onom25/work/301s/readme.txt

301s_drive1		ピエゾドライバー、ディスクリート版
301s_drive2		ピエゾドライバー、廉価版
301s_FT202H		FT232Hアクセスモック
FT232H_powershell	FT232H高速転送評価ツール
FT232H_quartus		301s_FT232H用のQuartus
wave_301s		cygwin 波形情報の読込、書込ツール
mmp5500_301s		DMX100の専用ファーム server\Elec\mmp301s\prototype\mmp5500_301s で管理する
