onom25/work/301s/wave_301s/readme.txt

wave_301s は、DMX100の波形を外部から指定するためのツールである。

引数
wave_301s.exe 192.168.1.170 argv[2] argv[3] argv[4]
引数を英小文字で指定した場合は大文字に内部で変換される。

RRANK
	ヘッドランクIDと波形番号をターゲットから読み込み、tmp.dat構造体に格納する。

RKIND
	FPGAの波形毎先頭アドレスレジスタ 0x0500_0044 から 0x0500_0050 までの
	値をターゲットから読み込み、tmp.dat構造体に格納する
	ヘッドと放熱器のサーミスタ温度も読み込まれる。

RWAVE <adr> <len>
	FPGAの波形メモリの任意番地を指定長さで読み込む。
	<adr> <len> が無指定の場合は 先頭 0x0500_8000 から 0x0500_BFFF までの
	16KB を読み込む。
	読み込んだ値は、 tmp.dat構造体ファイルに格納される。

DISP <名称>
	tmp.dat に格納されている波形情報を表示する。(ターゲットの値ではない)
	名称							(別称)
	RANK		ヘッドランク
	KIND		波形毎先頭アドレスレジスタ値
	STOP		停止波形データ		(_stop)
	START		開始波形データ		(_start)
	TERMINATE	終端波形データ		(_terminate)
	ROCK4		印字外微振動波形	(_rocking_outofarea)
	ROCK5		印字前微振動波形	(_rocking_beforeprint)
	FLASH		フラッシング波形	(_flashing)
	PRINT		印字波形			(_print)

	+------------------------------------------------------
	| no. E N C L  DAC         [ROCK5] wave head point 0x0680
	|   0 1 0 0 0 0x010e[  270]
	|
	E列 ENB		0のデータで波形の終わりとしている
	N列 NCHG	NCHG信号
	C列 CH		CH信号
	L列 LAT		LAT信号
		[ROCK5]波形は オフセット0x0680 の先頭から、始まっている。

WRANK <波形番号>
	0	F1440-VSD2(微振動なし)
	1	F1440-VSD2(微振動あり)
	2	PX5800-VSD2
	3	default(試験波形)

	20	評価機能
		プリンター内部の波形メモリーと波形毎先頭アドレスレジスタ更新を

	ヘッドランク自体を更新する機能はない。

WKIND <名称 | UPDATE> <値>
	名称( STOP | START | TERMINATE | ROCK4 | ROCK5 | FLASH | PRINT )の
	各波形先頭番地をしていするFPGAレジスタ値を入力する
	この変更においては tmp.dat構造体だけが更新され、ターゲットには反映されない
	値は 16進で (0x0..0x3ffc)の範囲で偶数指定する。
	終端データを含むと0x3ffe番地を指定することはできない、為受け付けない。

	名称(UPDATE) 値(0)
	名称にUPDATEを指定すると、tmp.dat構造体に保管されている値をターゲット
	に設定する

//--以下未実装

FSET <filename>
	構造体ファイルを開き、各波形先頭番地 と 波形メモリの全てを
	ターゲットに書き込む
	波形番号は反映されない。
	構造体ファイルを保管し、波形番号を20にすることで用意に波形を任意に
	指定できる。
