onom25/work/301s/FT232H_quartus/readme.txt

20260421
	_RXF立ち下がり直後に_RDに異常アサートが発生した点を対策した。
	修正したが治っていない。最初のnRDが1CLKに足りず、2サイクル目から有効なnRDとなっている。
20260423
	nRDの役割がデータ要求ではなく、受信ACK あるいは 次受信データ要求なので、ステートマシン変更

送信試験をしたいけれど UISWの動作が検証できない。
