onom25/work/301s/301s_drive1/memo20270804.pdf

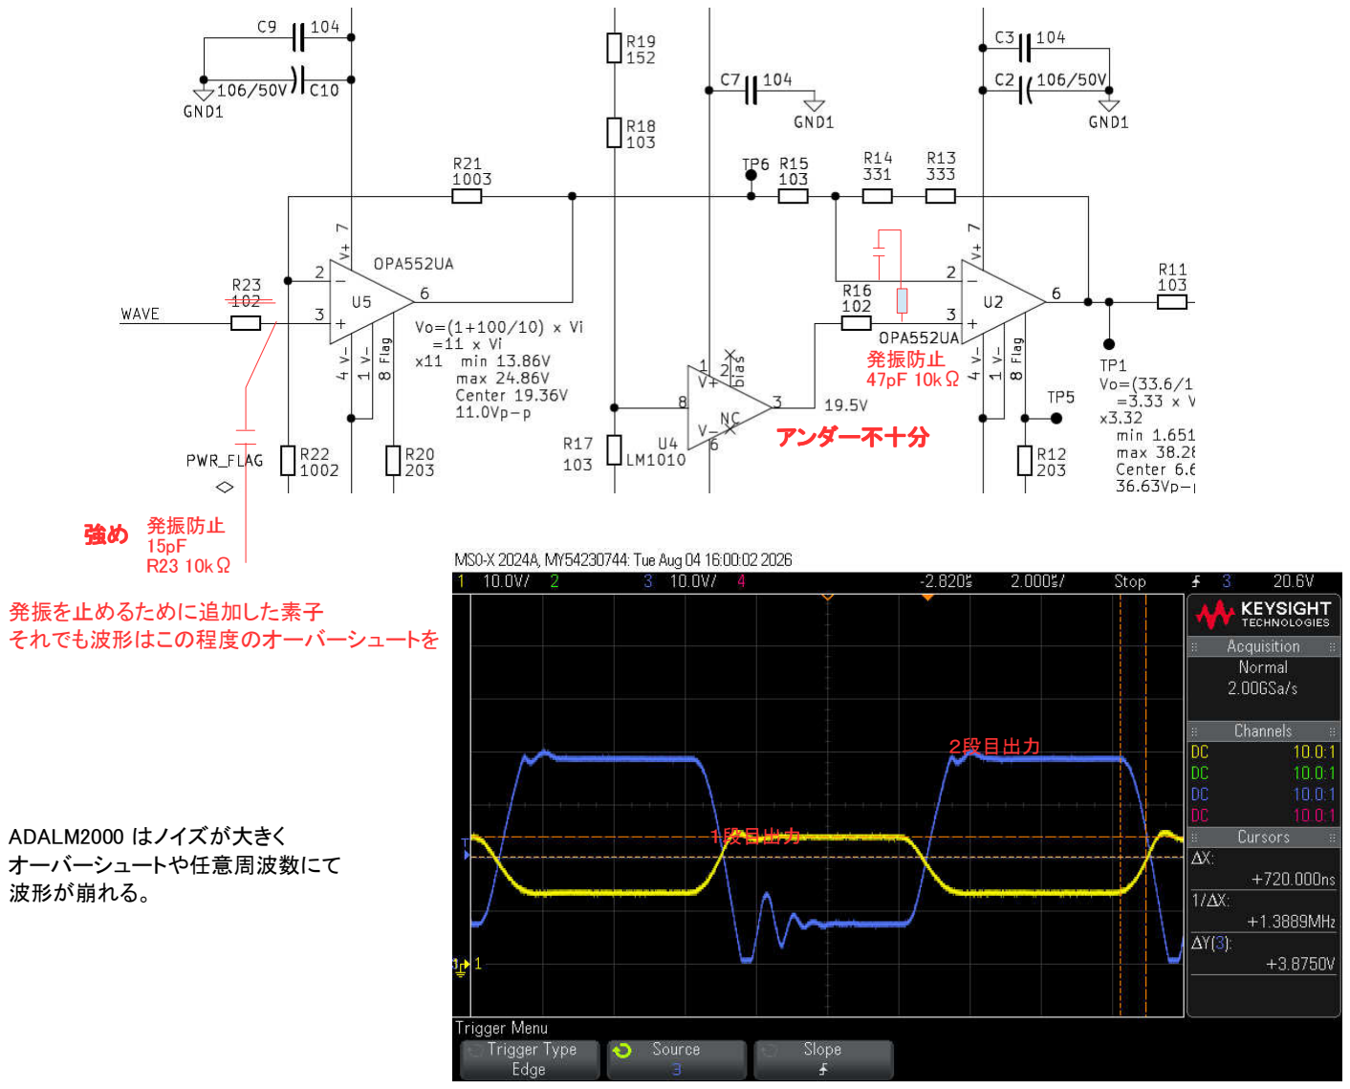
[picture p1: page 1]

発振を止めるために追加した素子
それでも波形はこの程度のオーバーシュートを

オーバーシュートや任意周波数にて
波形が崩れる。

ADALM2000 はノイズが大きく

強め

発振防止
47pF 10kΩ

発振防止
15pF
R23 10kΩ

１段目出力

２段目出力

アンダー不十分
