onom25/work/301s/FT232H_powershell/実行.png

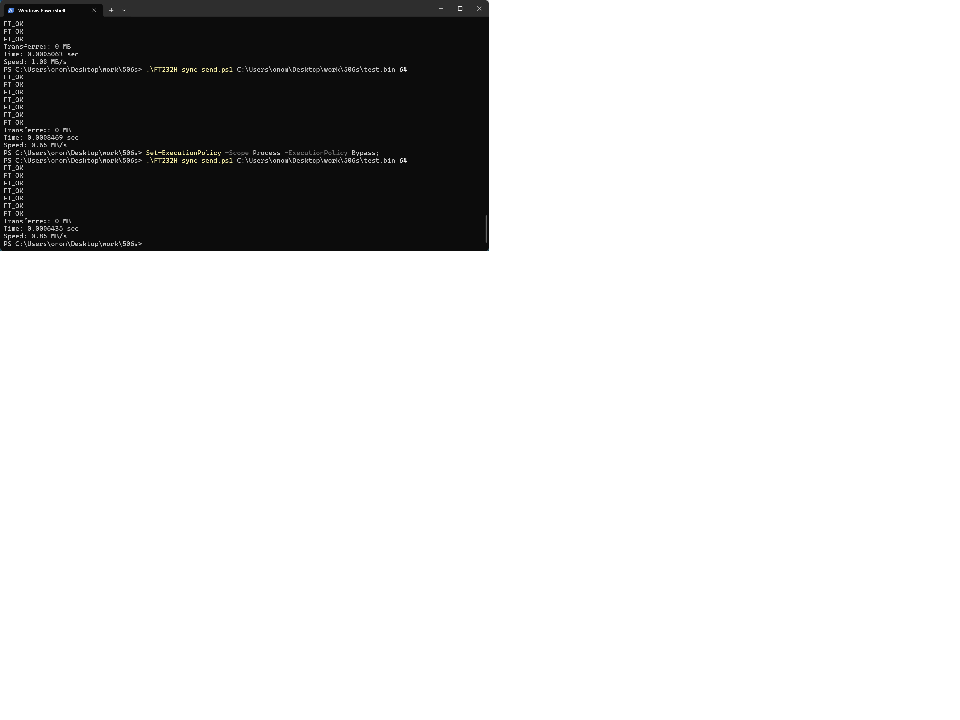
301s/FT232H_powershell/実行.png
