onom25/work/Mechanical/etcUnit/ASSY_CAP.stp

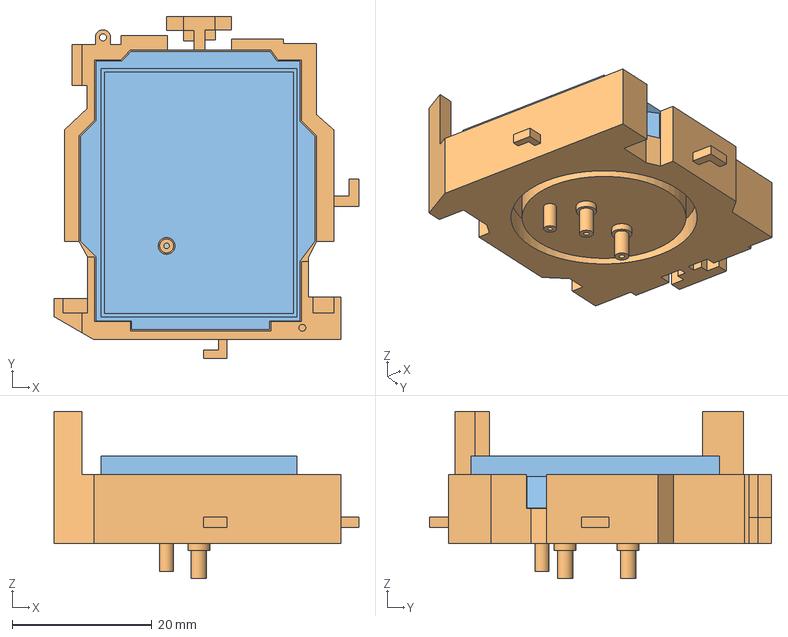
[picture p3: CAD file, 2026-06-05]
Mechanical/etcUnit/ASSY_CAP.stp
43.6 x 48.9 x 23.9 mm
Cap_holder
Blade
