onom25/work/Mechanical/etcUnit/P12-2GT-60.stp

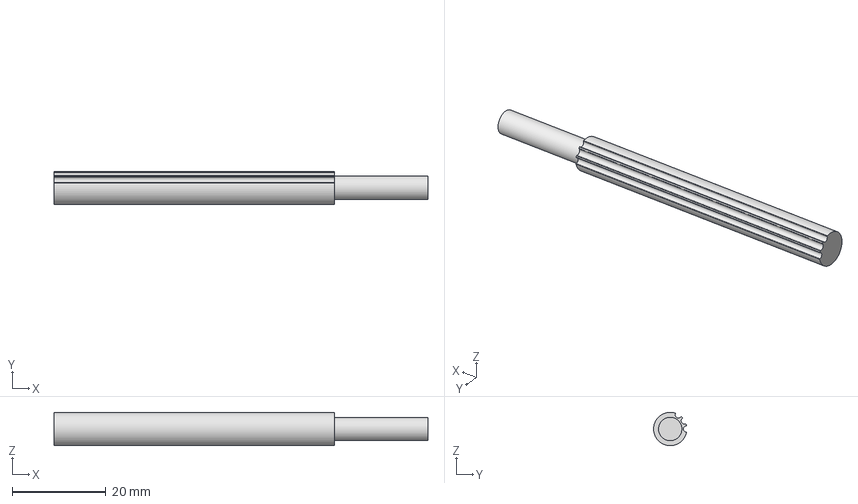
[picture p4: CAD file, 2026-10-16]
Mechanical/etcUnit/P12-2GT-60.stp
80.0 x 7.04 x 7.13 mm
