onom25/work/Mechanical/RGEAPL0.8KA-60-A5.stp

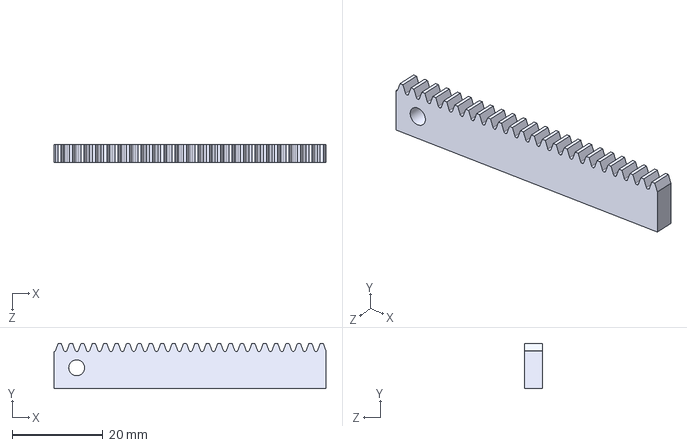
[picture p5: CAD file, 2026-10-16]
Mechanical/RGEAPL0.8KA-60-A5.stp
60.0 x 10.0 x 4.00 mm
