onom25/work/Mechanical/etcUnit/P13-1.5GT-1.5-33.stp

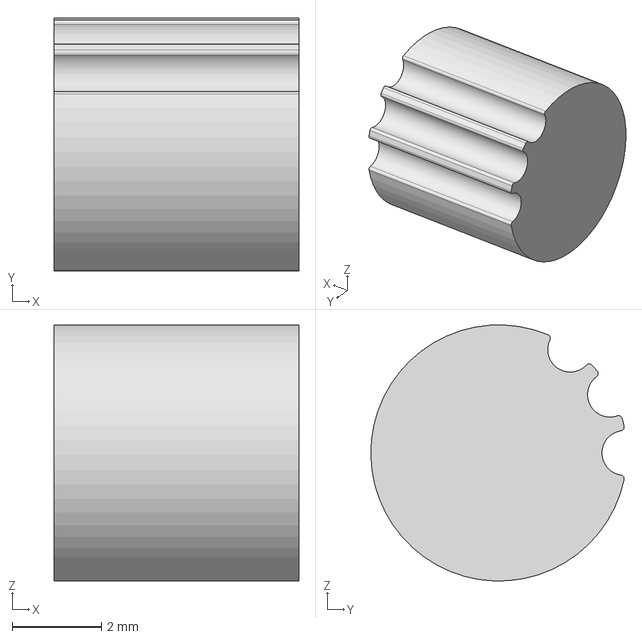
[picture p6: CAD file, 2026-10-16]
Mechanical/etcUnit/P13-1.5GT-1.5-33.stp
5.50 x 5.69 x 5.75 mm
