onom25/work/(list of files, cad)

Other CAD files:
301s/FT232H_quartus/db/uisw_auto_stripped.stp
301s/FT232H_quartus/nRD001.stp
301s/FT232H_quartus/db/nRD001_auto_stripped.stp
301s/FT232H_quartus/uisw.stp
