onom25/work/301s/FT232H_quartus/testbench/tb_testFT232H.pdf

読込1 | 書込1

読込2

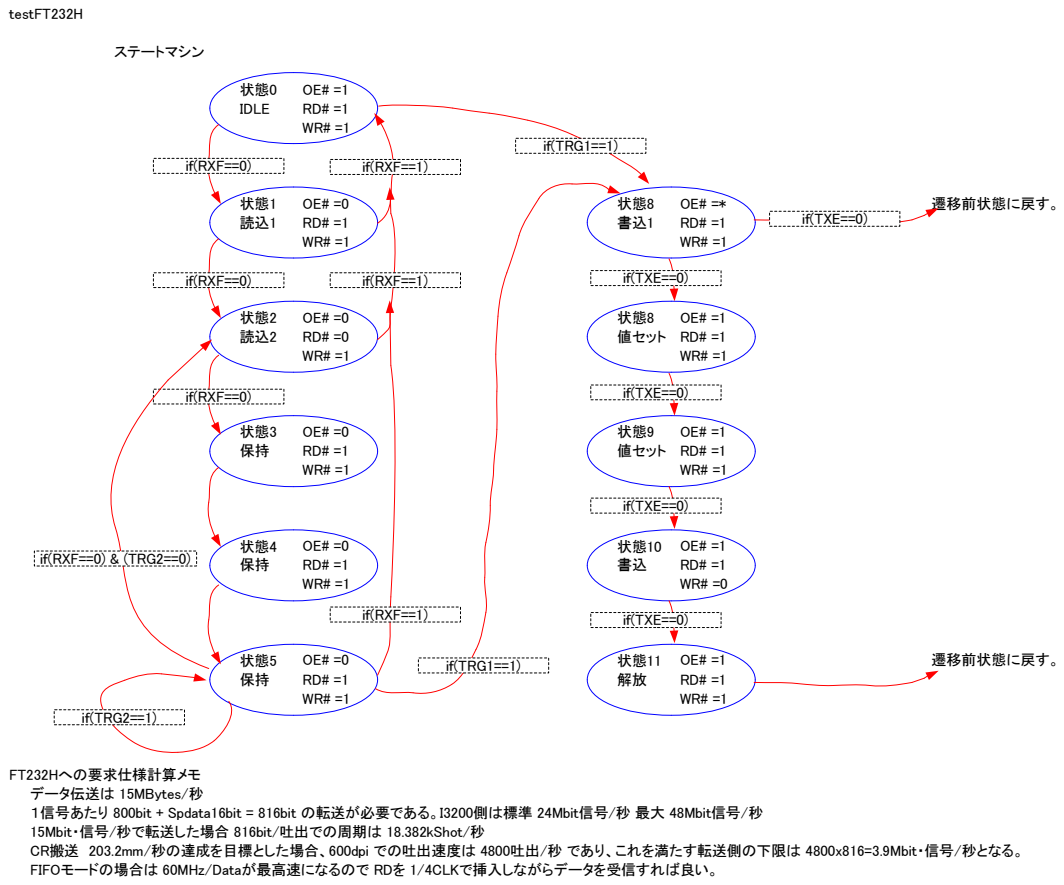
[picture p7: page 1]
testFT232H; ステートマシン; IDLE; 遷移前状態に戻す。; 値セット RD# =1; if(RXF==0); if(RXF==1); if(RXF==0) & (TRG2==0); if(TRG2==1); if(TRG1==1); if(TXE==0)

FT232Hへの要求仕様計算メモ
データ伝送は 15MBytes/秒
１信号あたり 800bit + Spdata16bit = 816bit の転送が必要である。I3200側は標準 24Mbit信号/秒 最大 48Mbit信号/秒
15Mbit・信号/秒で転送した場合 816bit/吐出での周期は 18.382kShot/秒
CR搬送　203.2mm/秒の達成を目標とした場合、600dpi での吐出速度は 4800吐出/秒 であり、これを満たす転送側の下限は 4800x816=3.9Mbit・信号/秒となる。
FIFOモードの場合は 60MHz/Dataが最高速になるので RDを 1/4CLKで挿入しながらデータを受信すれば良い。

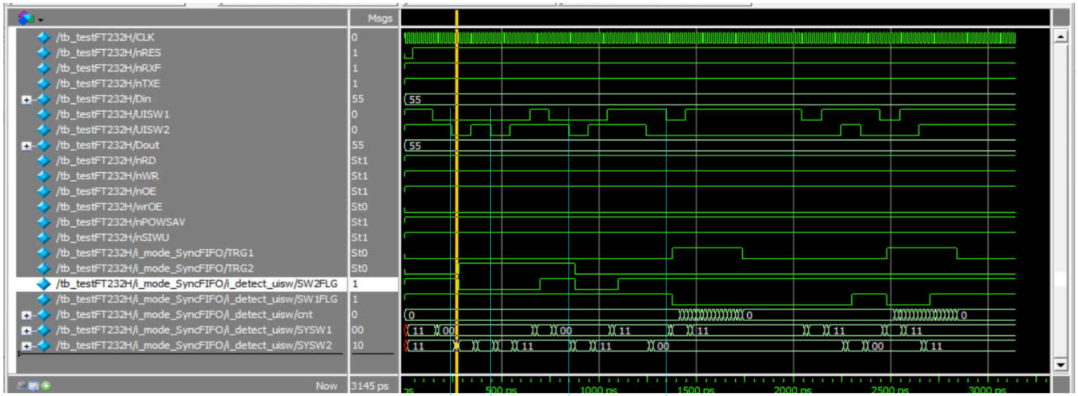
[picture p8: figure]
EMPTY; NEAR_EMPTY; NEAR_FULL

タイマー生成カウンタにより、リセットされる。

testFT232HのUI機能 | 検証用スイッチUI動作

SW1がONの時のSW2ONエッジでTRG2が反転する

SW2だけOFF・ONしても反応しない

両スイッチのOFFによりSW2FLGがセットされると、次の条件には応答する。

TRG1はスイッチ条件でセットされる。

両スイッチをOFFしないと、受付されないのは TRG2と同じ。

基本アクセスのステートマシン

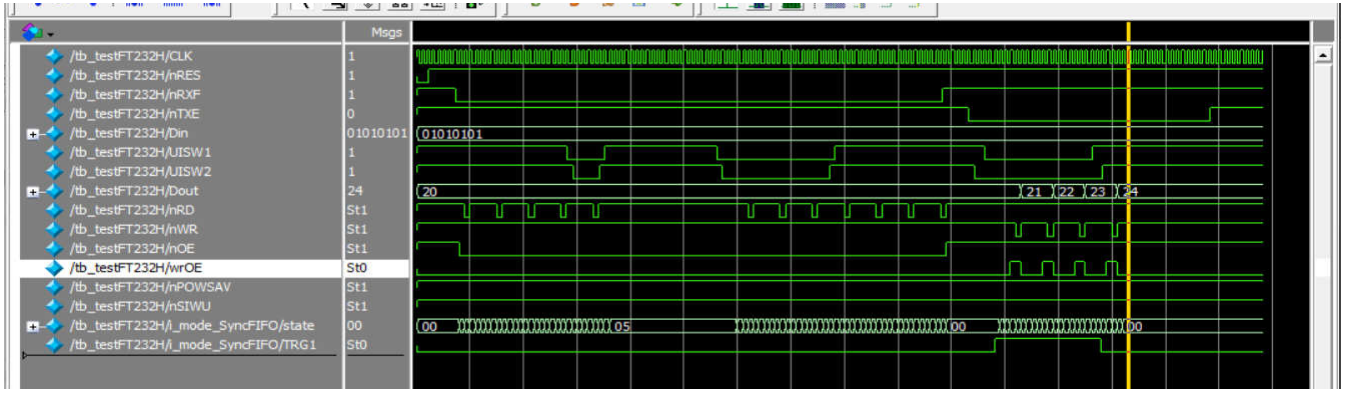
[picture p9: figure]
