onom25/work/301s/FT232H_quartus/testbench/tb_testFT232H.ods

Sheet: dac_control
testFT232H
 |  |  | ステートマシン
 |  |  |  |  |  | 状態0 | OE# =1
 |  |  |  |  |  | IDLE | RD# =1
 |  |  |  |  |  |  | WR# =1
 |  |  |  |  |  |  |  |  |  | if(TRG1==1)
 |  |  |  | if(RXF==0) |  |  |  | if(RXF==1)
 |  |  |  |  |  | 状態1 | OE# =0 |  |  |  |  | 状態8 | OE# =* |  | if(TXE==0) |  | 遷移前状態に戻す。
 |  |  |  |  |  | 読込1 | RD# =1 |  |  |  |  | 書込1 | RD# =1
 |  |  |  |  |  |  | WR# =1 |  |  |  |  |  | WR# =1
 |  |  |  | if(RXF==0) |  |  |  | if(RXF==1) |  |  | if(TXE==0)
 |  |  |  |  |  | 状態2 | OE# =0 |  |  |  |  | 状態8 | OE# =1
 |  |  |  |  |  | 読込2 | RD# =0 |  |  |  |  | 値セット | RD# =1
 |  |  |  |  |  |  | WR# =1 |  |  |  |  |  | WR# =1
 |  |  |  | if(RXF==0) |  |  |  |  |  |  | if(TXE==0)
 |  |  |  |  |  | 状態3 | OE# =0 |  |  |  |  | 状態9 | OE# =1
 |  |  |  |  |  | 保持 | RD# =1 |  |  |  |  | 値セット | RD# =1
 |  |  |  |  |  |  | WR# =1 |  |  |  |  |  | WR# =1
 |  |  |  |  |  |  |  |  |  |  | if(TXE==0)
 | if(RXF==0) & (TRG2==0) |  |  |  |  | 状態4 | OE# =0 |  |  |  |  | 状態10 | OE# =1
 |  |  |  |  |  | 保持 | RD# =1 |  |  |  |  | 書込 | RD# =1
 |  |  |  |  |  |  | WR# =1 |  |  |  |  |  | WR# =0
 |  |  |  |  |  |  |  | if(RXF==1) |  |  | if(TXE==0)
 |  |  |  |  |  | 状態5 | OE# =0 |  | if(TRG1==1) |  |  | 状態11 | OE# =1 |  |  |  | 遷移前状態に戻す。
 |  |  |  |  |  | 保持 | RD# =1 |  |  |  |  | 解放 | RD# =1
 |  |  |  |  |  |  | WR# =1 |  |  |  |  |  | WR# =1
 |  | if(TRG2==1)
FT232Hへの要求仕様計算メモ
 | データ伝送は 15MBytes/秒
 | １信号あたり 800bit + Spdata16bit = 816bit の転送が必要である。I3200側は標準 24Mbit信号/秒 最大 48Mbit信号/秒
 | 15Mbit・信号/秒で転送した場合 816bit/吐出での周期は 18.382kShot/秒
 | CR搬送 203.2mm/秒の達成を目標とした場合、600dpi での吐出速度は 4800吐出/秒 であり、これを満たす転送側の下限は 4800x816=3.9Mbit・信号/秒となる。
 | FIFOモードの場合は 60MHz/Dataが最高速になるので RDを 1/4CLKで挿入しながらデータを受信すれば良い。
testFT232HのUI機能 |  |  |  |  | 検証用スイッチUI動作
 |  |  |  |  |  |  | EMPTY
 |  |  |  |  |  |  | NEAR_EMPTY
 |  |  |  |  |  |  | NEAR_FULL
 |  |  |  |  |  |  | NEAR_EMPTY
 |  |  |  |  |  |  |  |  |  |  |  |  | SW1がONの時のSW2ONエッジでTRG2が反転する
 |  |  |  |  |  |  |  |  |  |  |  |  |  | SW2だけOFF・ONしても反応しない
 |  |  |  |  |  |  |  |  |  |  |  |  |  |  |  | 両スイッチのOFFによりSW2FLGがセットされると、次の条件には応答する。
 |  |  |  |  |  |  |  |  |  |  |  |  |  |  |  |  |  | TRG1はスイッチ条件でセットされる。
 |  |  |  |  |  |  |  |  |  |  |  |  |  |  |  |  |  | タイマー生成カウンタにより、リセットされる。
 |  |  |  |  |  |  |  |  |  |  |  |  |  |  |  |  |  | 両スイッチをOFFしないと、受付されないのは TRG2と同じ。
基本アクセスのステートマシン

Sheet: Sheet3
 |  | dac_control にして若干使用率は増加した。
 | ロジック使用率が55%になった。
 | メモリーはほとんど増えていない（少しだけ増えた）配置を確認する。
変更前後タイミング比較
 |  |  | BCLKセットアップ不足のほぼすべては DD[15:0]のCPUバス端子への出力における遅延である。
 |  |  | CS3領域は２クロックウェイトが挿入されて３クロックのリードサイクルであり、SETUPの余裕は十分にあるはずです。
 | チッププランナー で使用リソースはメモリーとM9Kが主に使われており、狙い通りになっている。
