onom25/work/301s/301s_drive1/301s_drive1_20260805.pdf

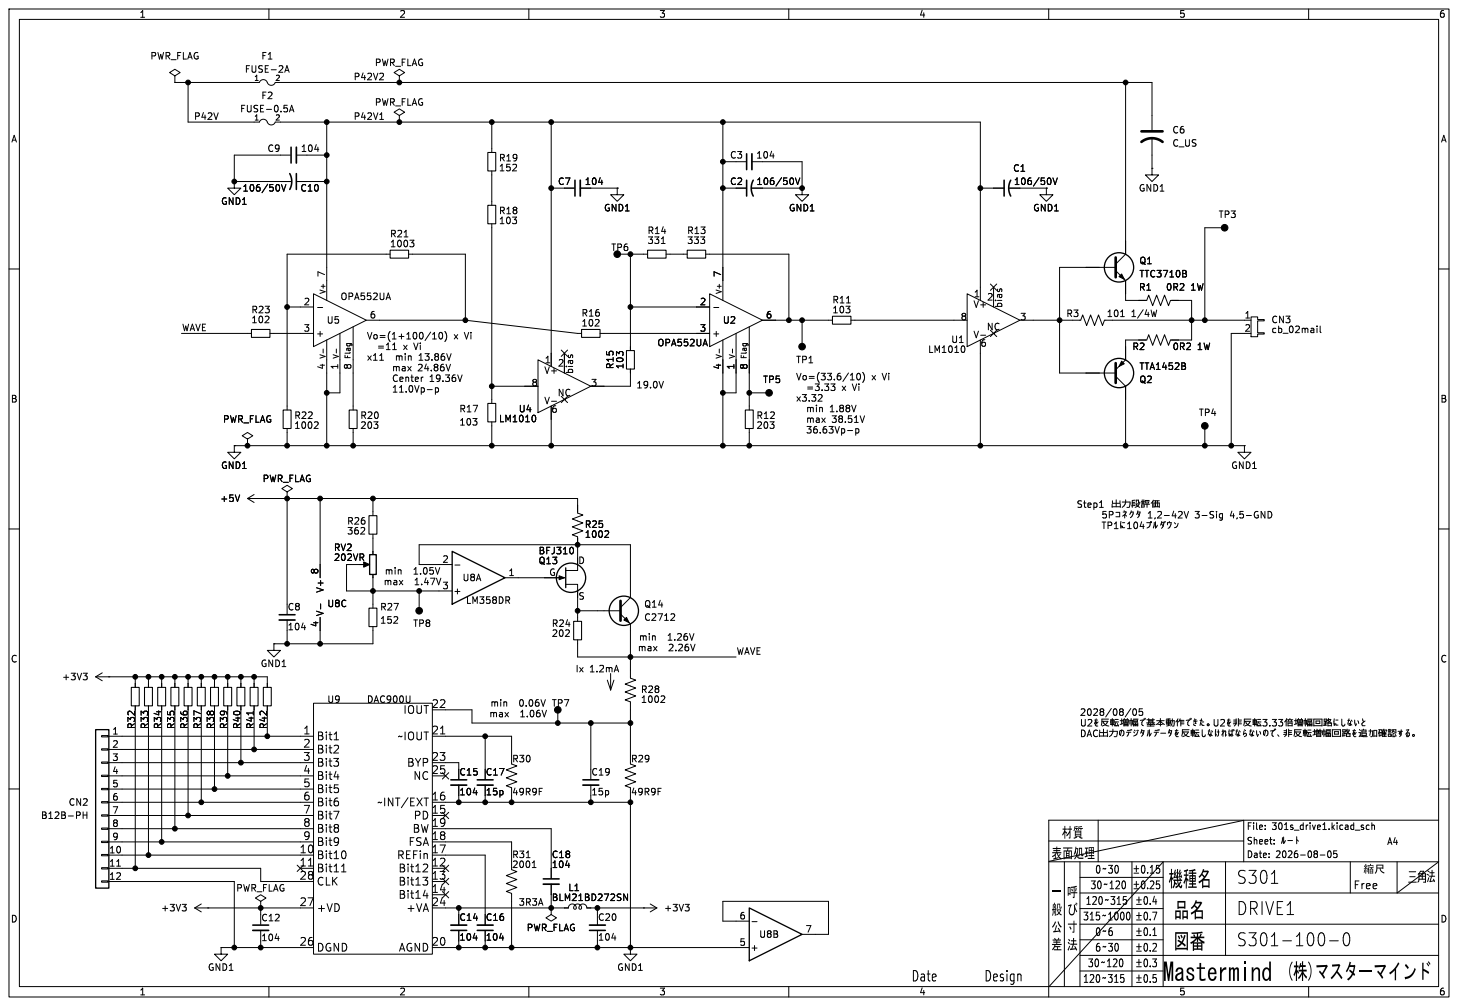
[picture p10: page 1]

þÿU20’SÍŽâX—^E0gWúg,RÕO\0g0M0_0-
þÿDACQúR›0n0Ç0¸0¿0ë0Ç0ü0¿0’SÍŽâ0W0j0Q0Œ0p0j0‰0j0D0n0g0—^SÍŽâX—^EVÞ•ï0’•ýR xºŠ•0Y0‹0-
