onom25/work/301s/301s_drive1/301s_drive1_20260713.pdf

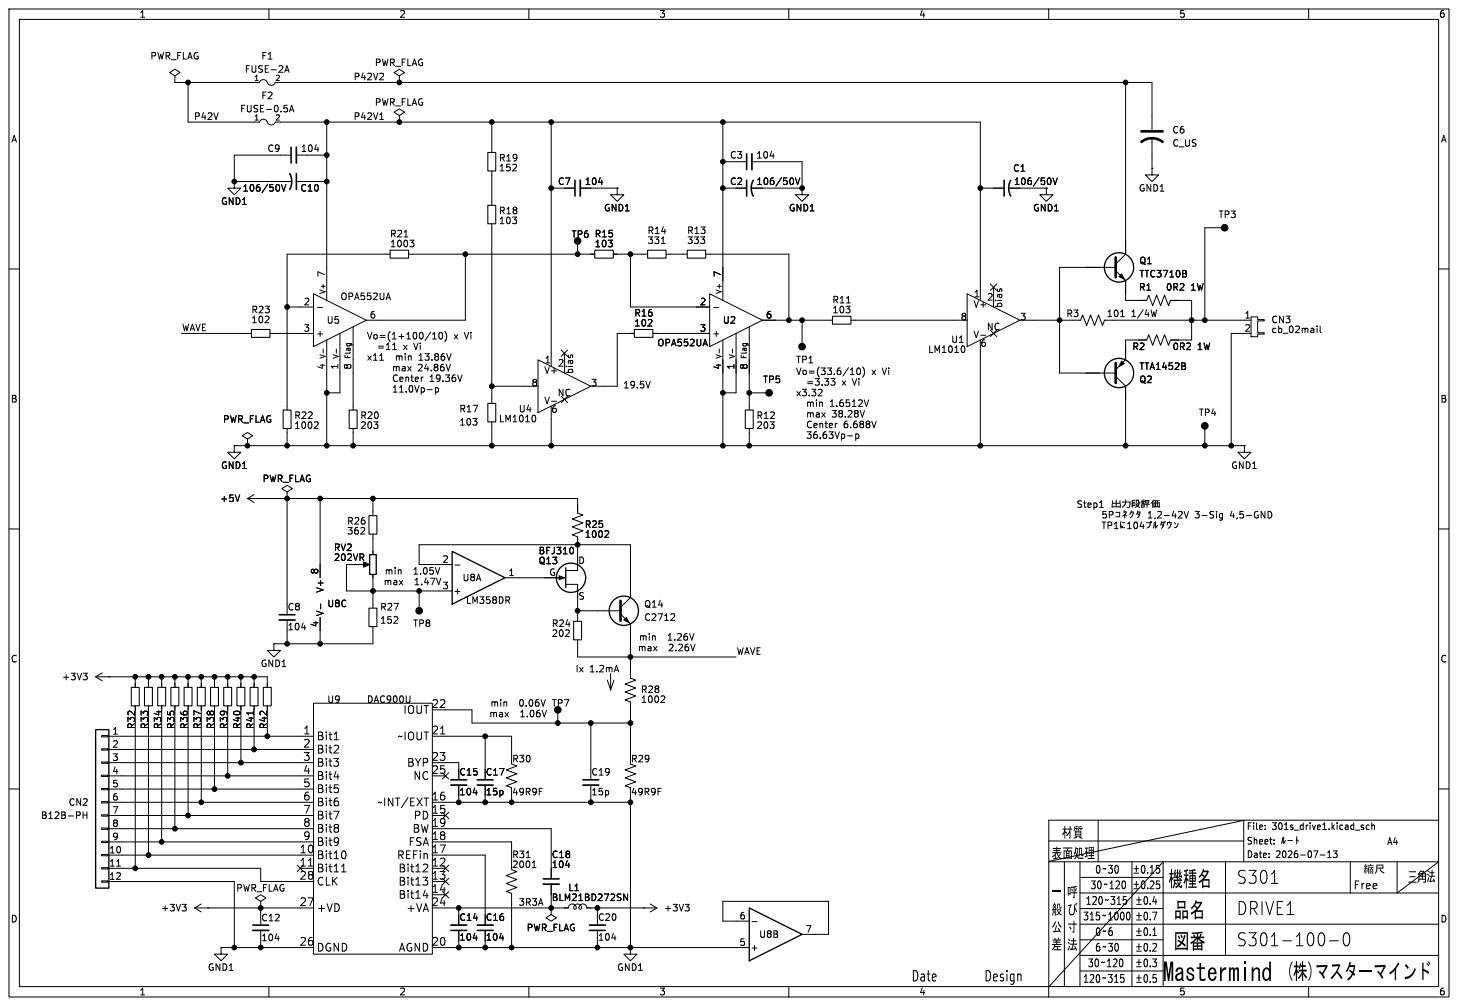
[picture p11: page 1]
