onom25/work/301s/301s_drive2/301s_drive2_20260626.pdf

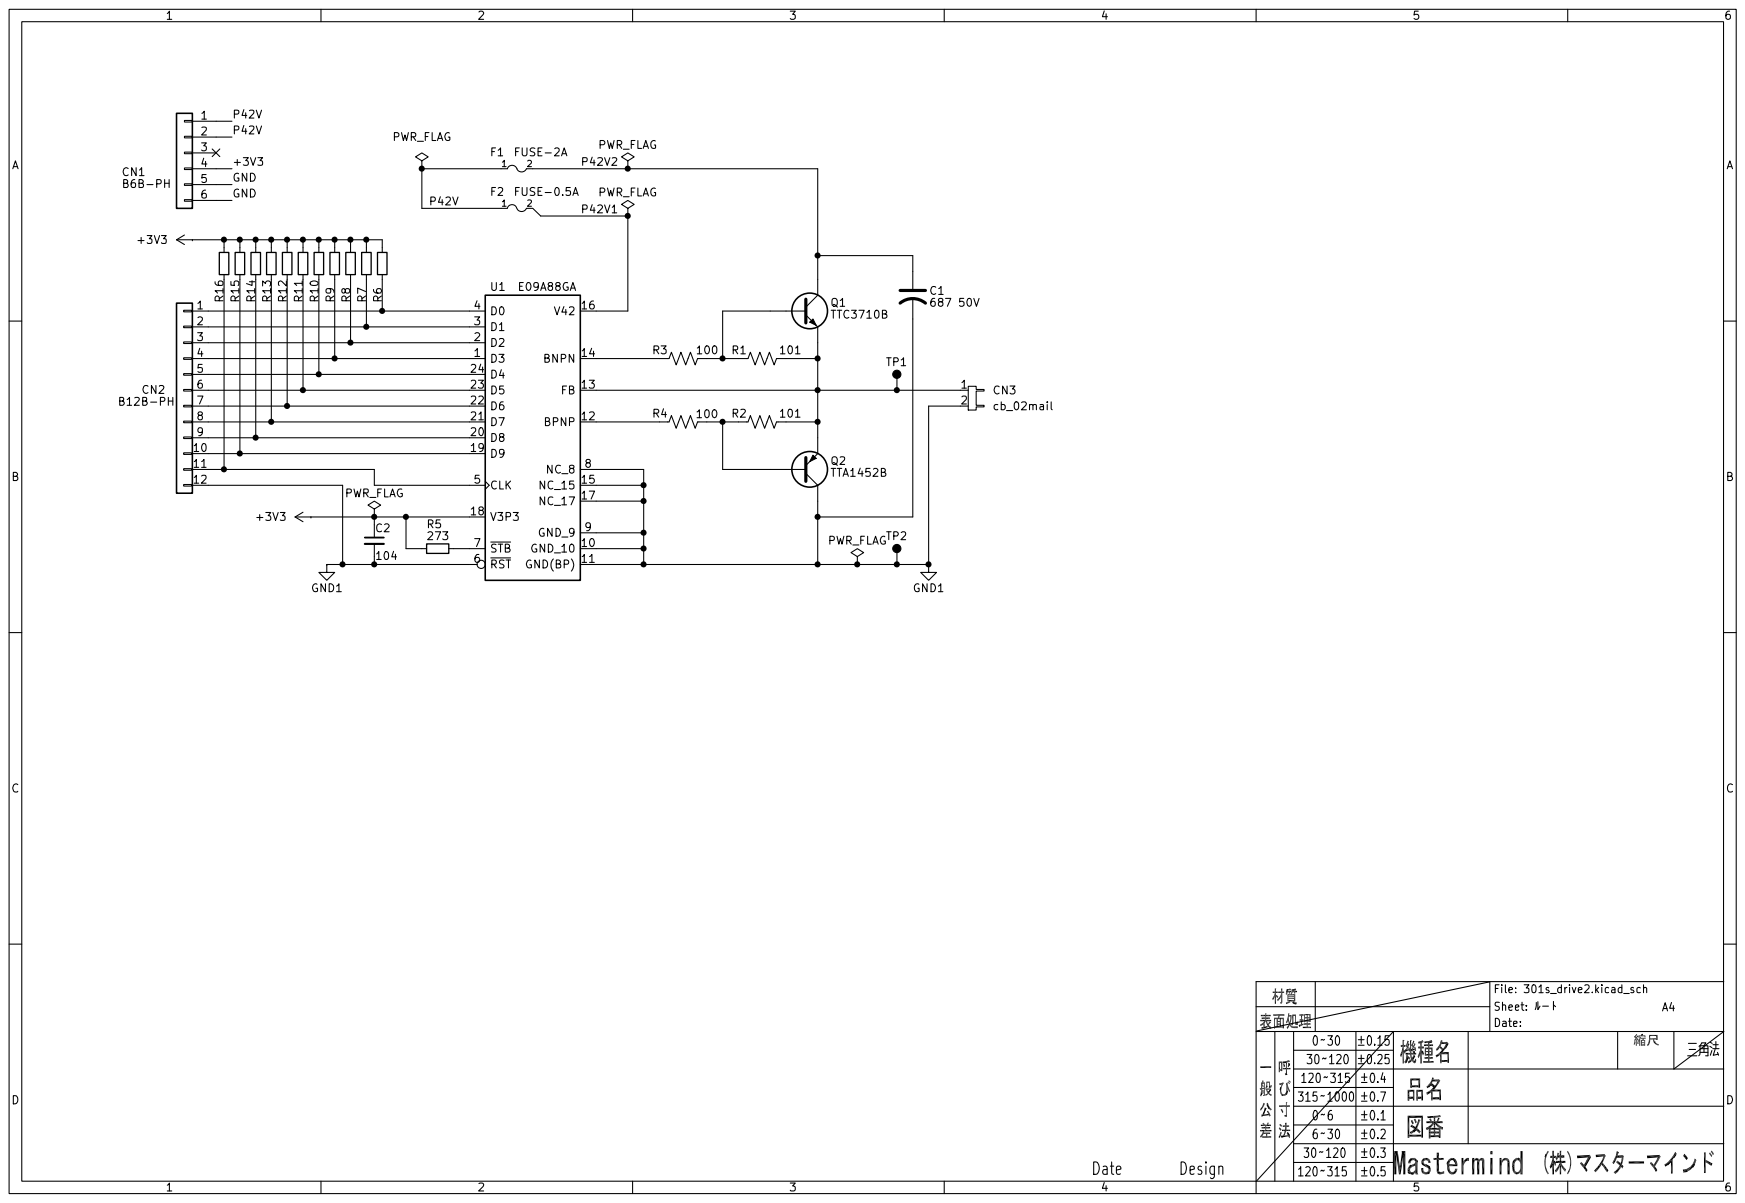
[picture p12: page 1]
