onom25/work/301s/301s_FT202H/mmp506s-cnt90.pdf

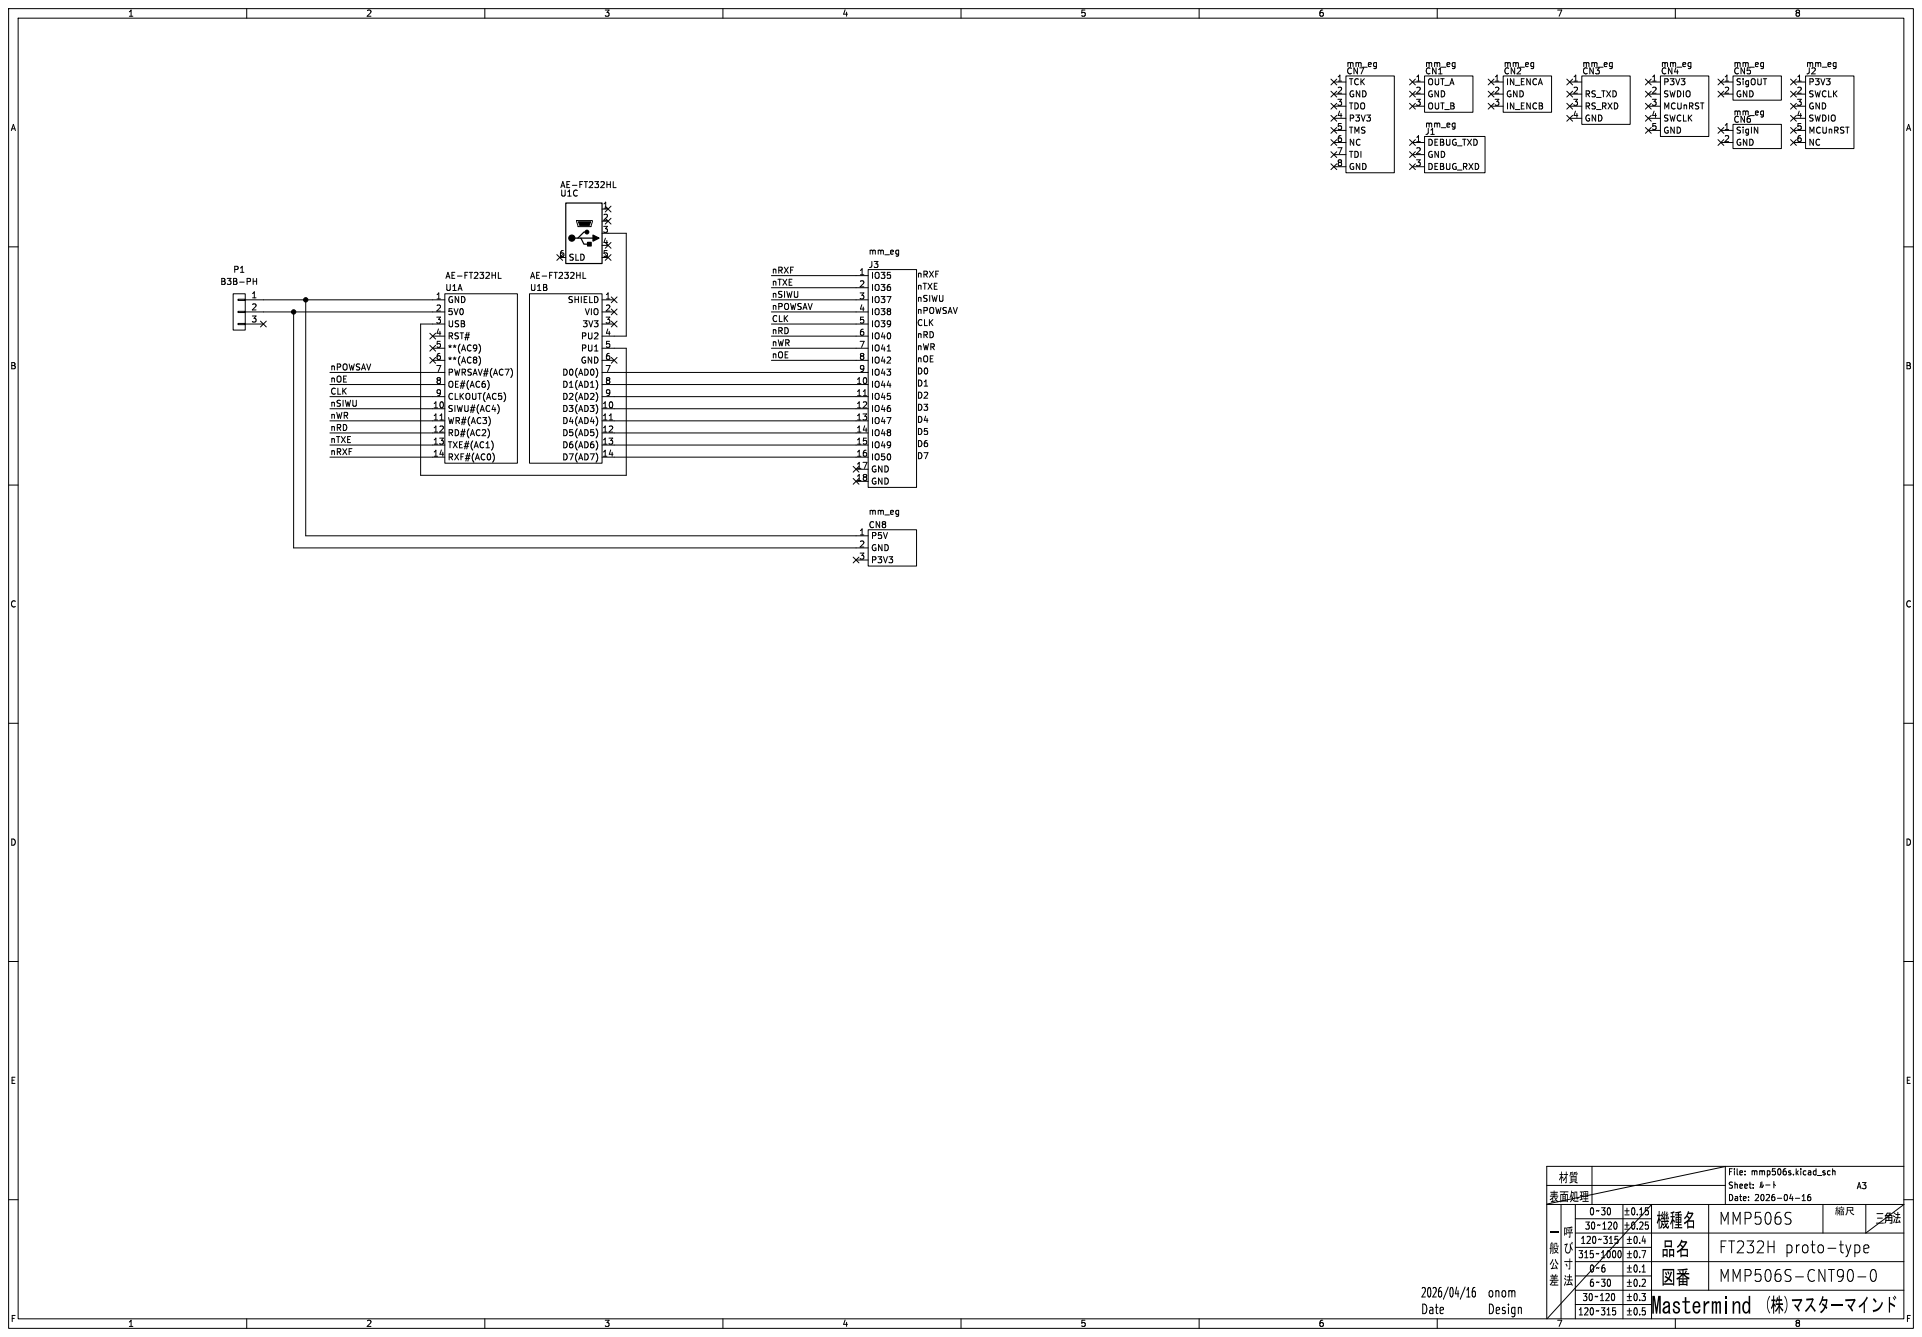
[picture p13: page 1]
