onom25/work/301s/301s_drive1/301s_drive1.kicad_pcb

## KiCad design 301s/301s_drive1/301s_drive1.kicad_pcb (2026-07-13)

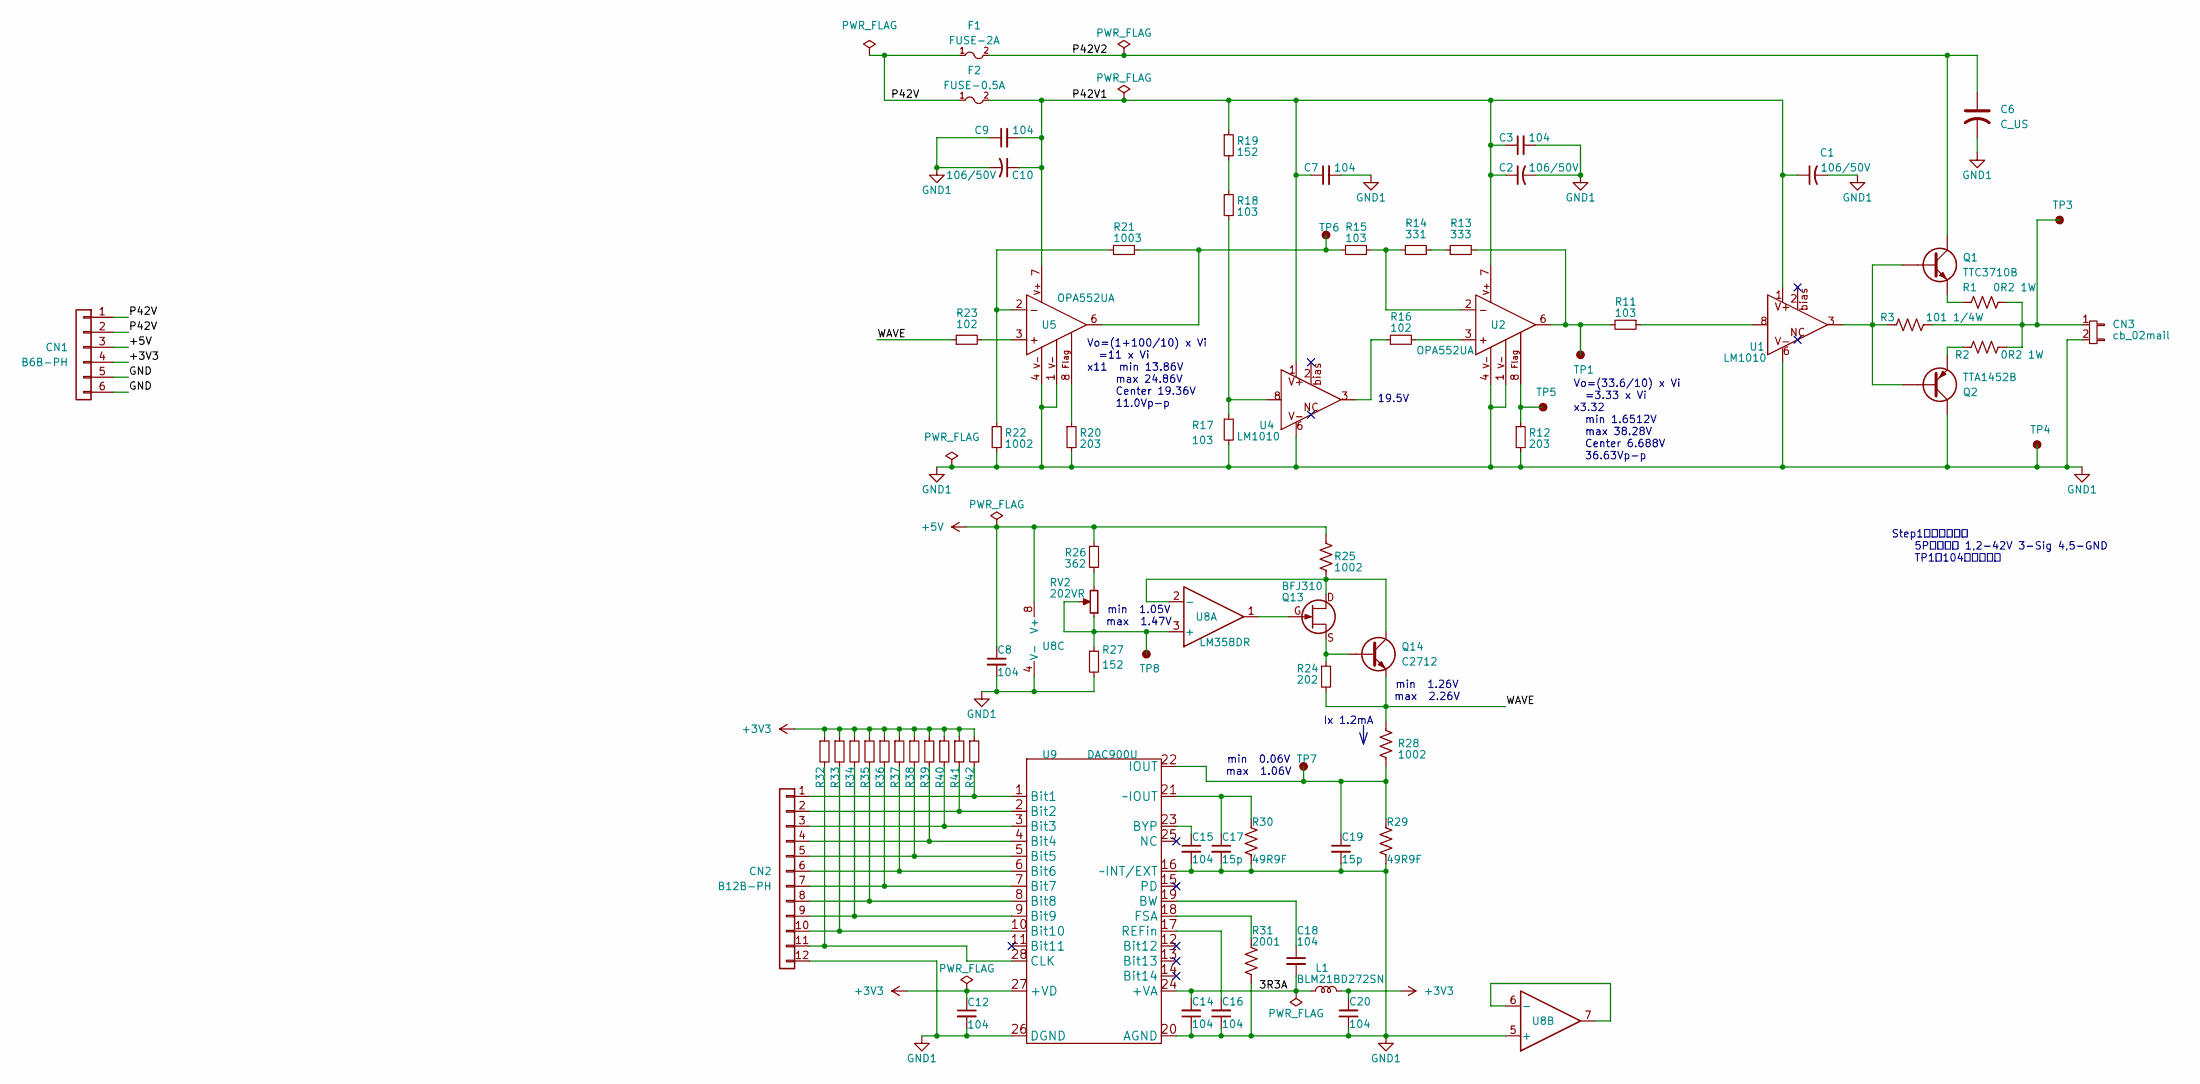
[picture p14: schematic 301s_drive1.kicad_sch]

Parts:
C1, C2, C10: 106/50V; CP_Radial_D5.0mm_P2.00mm
C3, C7, C8, C9, C12, C14, C15, C16, C18, C20: 104; _2012
C6: C_US; CP_Radial_D12.6mm_P5.0mm
C17, C19: 15p; _2012
CN1: B6B-PH; B06B-PH
CN2: B12B-PH
CN3: cb_02mail; B02B-PH
F1: FUSE-2A; FUSE0154_
F2: FUSE-0.5A; FUSE0154_
L1: BLM21BD272SN; _2012
Q1: TTC3710B; TO-220L
Q2: TTA1452B; TO-220L
Q13: BFJ310
Q14: C2712; 2SC2712
R1, R2: 0R2 1W; R_12
R3: 101 1/4W; R_7.62
R11, R15, R17, R18: 103; R_1608
R12, R20: 203; R_1608
R13: 333; R_1608
R14: 331; R_1608
R16, R23: 102; R_1608
R19, R27: 152; R_1608
R21: 1003; R_1608
R22, R25, R28: 1002; R_1608
R24: 202; R_1608
R26: 362; R_1608
R29, R30: 49R9F; R_1608
R31: 2001; _2012
R32, R33, R34, R35, R36, R37, R38, R39, R40, R41, R42: 273; R_1608
RV2: 202VR; GF063
TP1, TP3, TP4, TP5, TP6, TP7, TP8: CB; VIA1.4_inch
U1, U4: LM1010; DIP-8_W7.62
U2, U5: OPA552UA; LM358D_SOIC
U8: LM358DR; LM358D_SOIC
U9: DAC900U; DAC900U_SOIC28

Connections:
+3V3: C12.1, C20.2, CN1.4, L1.2, R32.1, R33.1, R34.1, R35.1, R36.1, R37.1, R38.1, R39.1, R40.1, R41.1, R42.1, U9.27 (+VD)
+5V: C8.1, CN1.3, R25.2, R26.1, U8.8 (V+)
/3R3A: C14.2, C18.2, L1.1, U9.24 (+VA)
/GND: CN1.5, CN1.6
/P42V: CN1.1, CN1.2, F1.1, F2.1
/P42V1: C1.1, C2.1, C3.1, C7.1, C9.2, C10.1, F2.2, R19.1, U1.1 (V+), U2.7 (V+), U4.1 (V+), U5.7 (V+); also elsewhere on the board
/P42V2: C6.1, F1.2, Q1.C
/WAVE: Q14.E, R23.1, R24.2, R28.1
GND1: C1.2, C2.2, C3.2, C6.2, C7.2, C8.2, C9.1, C10.2, C12.2, C14.1, C15.2, C16.1, C17.2, C19.2, C20.1, CN2.12, CN3.2, Q2.C, R12.2, R17.2, R20.2, R22.2, R27.2, R29.1, R30.1, R31.2, TP4.1, U1.6 (V-), U2.1 (V-), U2.4 (V-), U2.5 (V-), U4.6 (V-), U5.1 (V-), U5.4 (V-), U5.5 (V-), U8.4 (V-), U8.5 (+), U9.16 (~INT/EXT), U9.20 (AGND), U9.26 (DGND); also elsewhere on the board
unnamed: CN2.1, R42.2, U9.1 (Bit1)
unnamed: CN2.2, R41.2, U9.2 (Bit2)
unnamed: CN2.3, R40.2, U9.3 (Bit3)
unnamed: CN2.4, R39.2, U9.4 (Bit4)
unnamed: CN2.5, R38.2, U9.5 (Bit5)
unnamed: CN2.6, R37.2, U9.6 (Bit6)
unnamed: CN2.7, R36.2, U9.7 (Bit7)
unnamed: CN2.8, R35.2, U9.8 (Bit8)
unnamed: CN2.9, R34.2, U9.9 (Bit9)
unnamed: CN2.10, R33.2, U9.10 (Bit10)
unnamed: CN2.11, R32.2, U9.28 (CLK)
unnamed: CN3.1, R1.1, R2.2, R3.1, TP3.1
unnamed: Q1.B, Q2.B, R3.2, U1.3
unnamed: Q1.E, R1.2
unnamed: Q2.E, R2.1
unnamed: Q13.G, U8.1
unnamed: Q13.S, Q14.B, R24.1
unnamed: R13.1, R14.2
unnamed: R16.1, U4.3
unnamed: R18.1, R19.2
unnamed: R26.2, RV2.3
unnamed: R11.1, U1.8 (INPUT)
unnamed: R16.2, U2.3 (+IN)
unnamed: R14.1, R15.2, U2.2 (-IN)
unnamed 33: R12.1, TP5.1, U2.8 (Flag); also elsewhere on the board
unnamed: R11.2, R13.2, TP1.1, U2.6 (OUT)
unnamed: R17.1, R18.2, U4.8 (INPUT)
unnamed: R23.2, U5.3 (+IN)
unnamed: R21.1, R22.1, U5.2 (-IN)
unnamed: R20.1, U5.8 (Flag)
unnamed: R15.1, R21.2, TP6.1, U5.6 (OUT)
unnamed: R27.1, RV2.1, RV2.2, TP8.1, U8.3 (+)
unnamed: Q13.D, Q14.C, R25.1, U8.2 (-)
unnamed: U8.6 (-), U8.7
unnamed: C18.1, U9.19 (BW)
unnamed: C15.1, U9.23 (BYP)
unnamed: R31.1, U9.18 (FSA)
unnamed: C19.1, R28.2, R29.2, TP7.1, U9.22 (IOUT)
unnamed: C16.2, U9.17 (REFin)
unnamed: C17.1, R30.2, U9.21 (~IOUT)

Notes on the sheet:
min 1.26V max 2.26V
Step1 出力段評価 5Pコネクタ 1,2-42V 3-Sig 4,5-GND TP1に104プルダウン
min 1.05V max 1.47V
19.5V
Ix 1.2mA
Vo=(1+100/10) x Vi =11 x Vi x11 min 13.86V max 24.86V Center 19.36V 11.0Vp-p
Vo=(33.6/10) x Vi =3.33 x Vi x3.32 min 1.6512V max 38.28V Center 6.688V 36.63Vp-p
min 0.06V max 1.06V

Board: 2 copper layers, 79 parts (0 on the bottom side), 49 nets, no tracks yet.

Other parts of the board:
C4: 106/50V; CP_Radial_D5.0mm_P2.00mm
C5: 104; _2012
R10: 273; R_1608
TP2: CB; VIA1.4_inch

Their connections:
/P42V1: C4.1, C5.1; also elsewhere on the board
GND1: C4.2, C5.2, R10.2; also elsewhere on the board
unnamed 33: R10.1, TP2.1; also elsewhere on the board
