onom25/work/301s/301s_drive2/301s_drive2.kicad_pcb

## KiCad design 301s/301s_drive2/301s_drive2.kicad_pcb (2026-07-10)

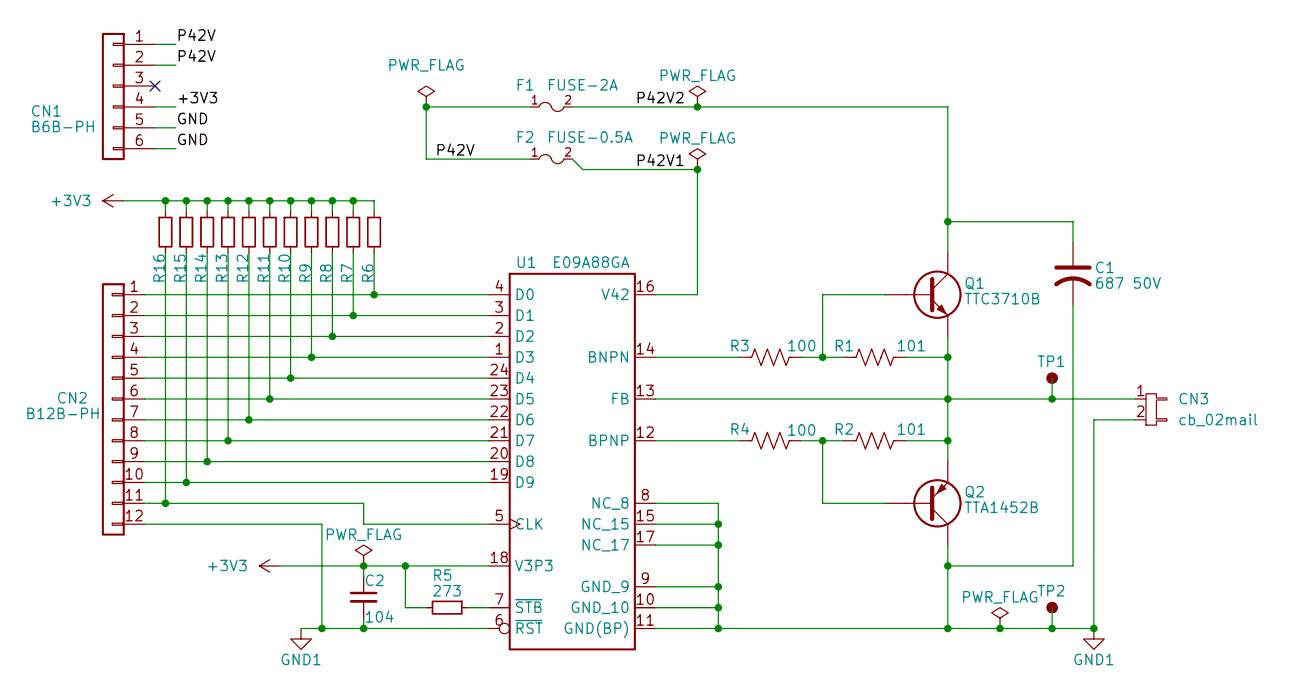
[picture p15: schematic 301s_drive2.kicad_sch]

Parts:
C1: 687 50V; CP_Radial_D12.6mm_P5.0mm
C2: 104; _2012
CN1: B6B-PH; B06B-PH
CN2: B12B-PH
CN3: cb_02mail; B02B-PH
F1: FUSE-2A; FUSE0154_
F2: FUSE-0.5A; FUSE0154_
Q1: TTC3710B; TO-220L
Q2: TTA1452B; TO-220L
R1, R2: 101; R_1608
R3, R4: 100; R_7.62
R5, R6, R7, R8, R9, R10, R11, R12, R13, R14, R15, R16: 273; R_1608
TP1, TP2: CB; VIA1.4_inch
U1: E09A88GA; E09A88GA_SOIC24

Connections:
+3V3: C2.1, CN1.4, R5.2, R6.1, R7.1, R8.1, R9.1, R10.1, R11.1, R12.1, R13.1, R14.1, R15.1, R16.1, U1.18 (V3P3)
/GND: CN1.5, CN1.6
/P42V: CN1.1, CN1.2, F1.1, F2.1
/P42V1: F2.2, U1.16 (V42)
/P42V2: C1.1, F1.2, Q1.C
GND1: C1.2, C2.2, CN2.12, CN3.2, Q2.C, TP2.1, U1.6 (~RST), U1.8 (NC_8), U1.9 (GND_9), U1.10 (GND_10), U1.11 (GND(BP)), U1.15 (NC_15), U1.17 (NC_17)
unnamed: CN2.1, R6.2, U1.4 (D0)
unnamed: CN2.2, R7.2, U1.3 (D1)
unnamed: CN2.3, R8.2, U1.2 (D2)
unnamed: CN2.4, R9.2, U1.1 (D3)
unnamed: CN2.5, R10.2, U1.24 (D4)
unnamed: CN2.6, R11.2, U1.23 (D5)
unnamed: CN2.7, R12.2, U1.22 (D6)
unnamed: CN2.8, R13.2, U1.21 (D7)
unnamed: CN2.9, R14.2, U1.20 (D8)
unnamed: CN2.10, R15.2, U1.19 (D9)
unnamed: CN2.11, R16.2, U1.5 (CLK)
unnamed: CN3.1, Q1.E, Q2.E, R1.1, R2.2, TP1.1, U1.13 (FB)
unnamed: Q1.B, R1.2, R3.1
unnamed: Q2.B, R2.1, R4.1
unnamed: R3.2, U1.14 (BNPN)
unnamed: R4.2, U1.12 (BPNP)
unnamed: R5.1, U1.7 (~STB)

Board: 2 copper layers, 28 parts (0 on the bottom side), 23 nets, no tracks yet.
