onom25/work/(commit log)

2026-05-12 first backup 20260512
    [やること.ods]
2026-05-13 add kicad9
2026-05-13 Add kicad project
2026-05-13 KiCAD add retry
    [mmp301s-p0.kicad_sch]
2026-05-13 KiCAD add dmx100 circuit pdf
2026-05-14 Add /mechanical CAD directory
2026-05-15 belt sample
    [GBN8002GT-40_.info-1-14-14.igs]
2026-05-15 add Mechanical Puly
    [P12-2GT-60.igs, P13-1.5GT-4-33.igs]
2026-05-18 update sch
    [mmp301s-p0.kicad_sch]
2026-05-18 add device datasheet
2026-05-25 20260525 update
    [mmp301s-p0.kicad_sch, やること.ods]
2026-06-05 update 20260605
    [ASSY_CAP.stp, GEAR15-BodyInvoluteGear.step, GEAR15_M0.4-BodyPad.step]
2026-06-08 update 20260608
    [mmp301s-p0.kicad_sch]
2026-06-16 add drive1
    [301s_drive1.kicad_pcb, 301s_drive1.kicad_sch, DRIVE_MOCK1.kicad_sch, mmp301s-p0.kicad_sch]
2026-07-10 update 20260710
    [301s_FT202H.kicad_sch, 301s_drive1.kicad_pcb, 301s_drive1.kicad_sch, 301s_drive2.kicad_pcb, 301s_drive2.kicad_sch, GBN8002GT-40_.info-1-14-14.igs, GEAR15-BodyInvoluteGear.step, GEAR15_M0.4-BodyPad.step]
2026-07-10 remove mmp310s-p0_k9
    [DRIVE_MOCK1.kicad_sch, mmp301s-p0.kicad_sch]
2026-07-13 update 20260713
    [301s_drive1.kicad_pcb, 301s_drive1.kicad_sch]
2026-08-04 2026/08/04 addition drive1 memo
    [memo.ods]
2026-08-05 update 20260805 Mechanical Assembly
    [GEAR32_M0.6.step, GEAR44M0.6.step, やること.ods]
2026-08-05 2026/08/05 update 3
    [301s_drive1.kicad_sch, memo.ods]
2026-08-27 2026-08-27 update Mechanical
    [やること.ods]
2026-10-16 Update 2026/10/16 PumpUnit Stop
