onom25/work/(notices)

Notices in the files:
Mechanical/etcUnit/P13-1.5GT-1.5-33.stp:
author */ ('License CC BY-ND 4.0'),
